wesleyv/Attiny-85-Midi-to-Tap-Converter/Schematic/Schematic - Attiny 85 Midi to Tap Converter.pdf

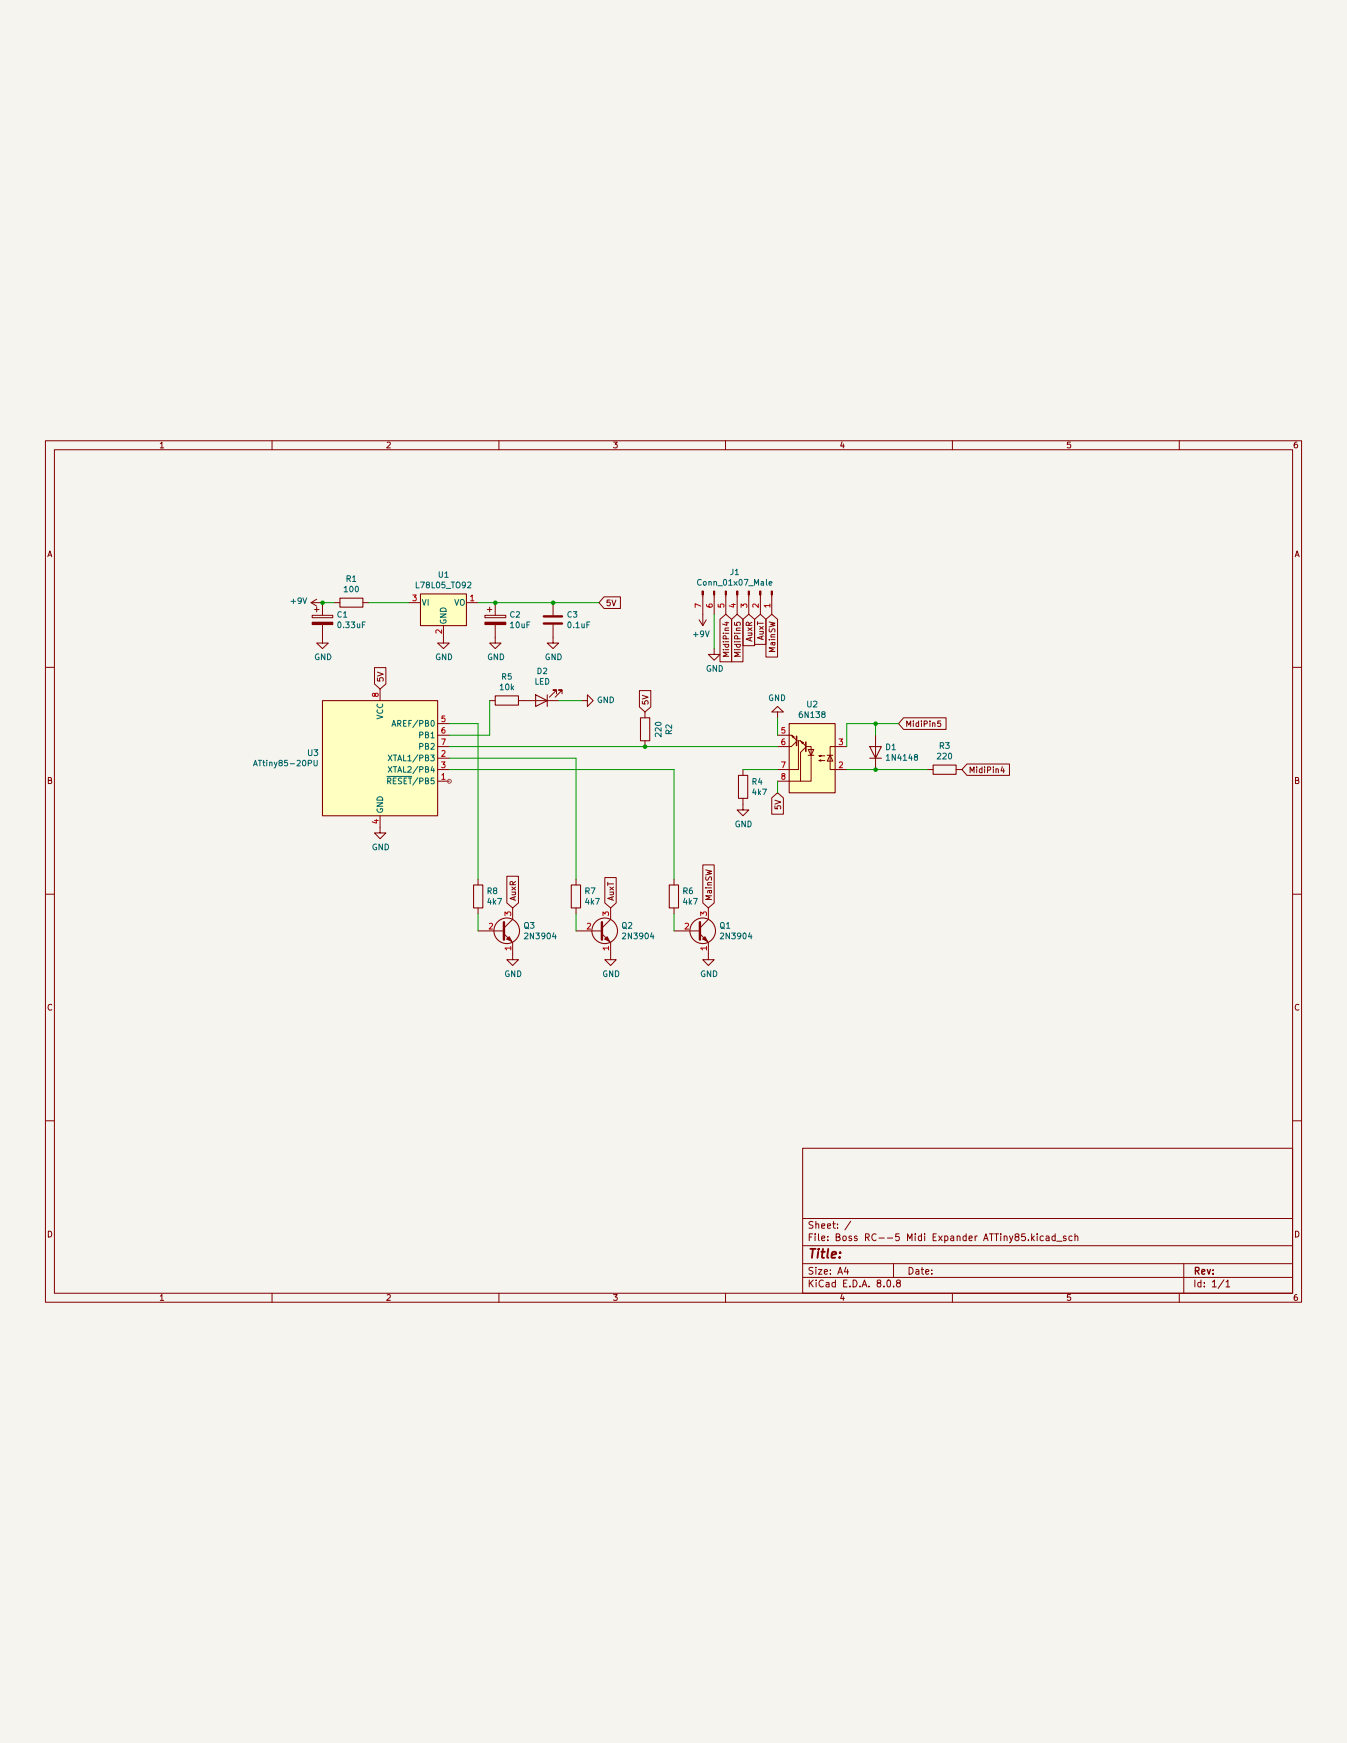
[picture p8: page 1]
