wesleyv/Attiny-85-Midi-to-Tap-Converter/attinymidi/Main.cpp

/*
 * Project Name: Attiny-85-Midi-to-Tap-Converter
 * Description: This is firmware for upgrading the MIDI functionality of the Boss-RC5 looper station, or adding midi functionality to any device that actuates buttons by shorting them to ground.
 * designed to run on ATTiny85.
 * 
 * Copyright (c) 2025 Wesley Van Der Veen
 * 
 * This software is released under the MIT License.
 * 
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
 * THE SOFTWARE AND HARDWARE IS PROVIDED "AS IS", WITHOUT WARRANTY OF ANY KIND, EXPRESS OR
 * IMPLIED, INCLUDING BUT NOT LIMITED TO THE WARRANTIES OF MERCHANTABILITY,
 * FITNESS FOR A PARTICULAR PURPOSE AND NONINFRINGEMENT. IN NO EVENT SHALL THE
 * AUTHORS OR COPYRIGHT HOLDERS BE LIABLE FOR ANY CLAIM, DAMAGES OR OTHER
 * LIABILITY, WHETHER IN AN ACTION OF CONTRACT, TORT OR OTHERWISE, ARISING FROM,
 * OUT OF OR IN CONNECTION WITH THE SOFTWARE OR THE USE OR OTHER DEALINGS IN THE
 * SOFTWARE.
 */

#include "Main.h"
#include "MidiParse.h"
#include "Pins.h"

#include <Arduino.h>
#include <SoftwareSerial.h>

#define MIDIRX 2

#define MIDICH 9
#define AUXTIP 3
#define AUXRING 0
#define MAINSWITCH 4
#define MIDISTATUS 1

#define AUXTIPCC 88
#define AUXRINGCC 89
#define MAINSWITCHCC 90

uint32_t now = 0;

SoftwareSerial midiSerial(MIDIRX, -1);
MidiParser parser;

void onControlChange(uint8_t channel, uint8_t data0, uint8_t data1)
{
    if (channel != MIDICH)
    {
        return;
    }
    if (data0 == AUXTIPCC && data1 == 0)
    {
        PinOn(AUXTIP, 1, now);
        PinOn(MIDISTATUS, 0, now);
    }
    else if (data0 == AUXRINGCC && data1 == 0)
    {
        PinOn(AUXRING, 2, now);
        PinOn(MIDISTATUS, 0, now);
    }
    else if (data0 == MAINSWITCHCC && data1 == 0)
    {
        PinOn(MAINSWITCH, 3, now);
        PinOn(MIDISTATUS, 0, now);
    }
}

void onError(MidiParserState state, uint8_t b)
{
    // No Op
}

void MainSetup()
{
    midiSerial.begin(31250); // MIDI Baud rate
    initializePin(MIDISTATUS);
    initializePin(AUXTIP);
    initializePin(AUXRING);
    initializePin(MAINSWITCH);

    parser = MidiParserInit(&onControlChange, &onError);
}

void MainLoop()
{
    now = micros();
    PinOff(MIDISTATUS, 0, now);
    PinOff(AUXTIP, 1, now);
    PinOff(AUXRING, 2, now);
    PinOff(MAINSWITCH, 3, now);
    if (!midiSerial.available())
    {
        return;
    }
    uint8_t b = midiSerial.read();
    MidiParserParse(&parser, b);
}
