wesleyv/Attiny-85-Midi-to-Tap-Converter/(commit log)

2024-05-16 Removed a long serial print line
2024-05-16 added arduino cli to git ignore
2024-05-19 Added pin off and pin on functions, ready for testing
2024-05-20 added additional serial prints for teensy troubleshooting
2025-03-16 Deleted Teensy Debugger, added index
2025-03-19 Added Subfolders for Schematic and Gerber
2025-03-20 Added Schematic
2025-03-23 Added Assembly Reference photos
2025-03-23 added BoM
    [Bill of Materials - Boss RC-5 Midi Expander.csv]
2025-03-23 Swapped reference photo midi and power lugs
